pu2clr/auto_bpf_arduino/extras/auto_band_pass_filter.sch

## EAGLE design extras/auto_band_pass_filter.sch (2020-11-26)

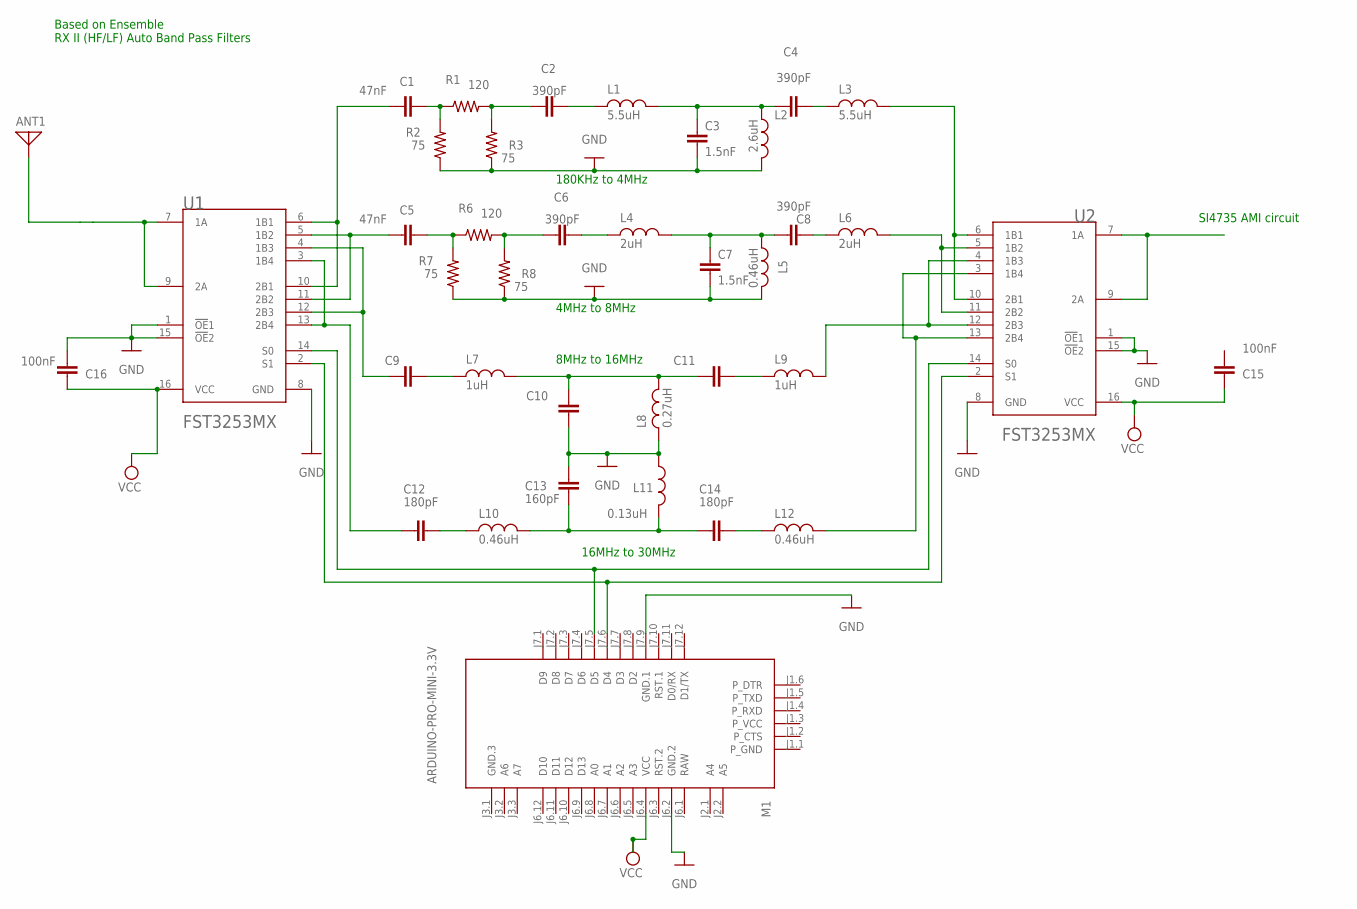
[picture p11: schematic auto_band_pass_filter.sch]

Parts:
ANT1: ANTENNA; PAD-01
C1, C5: 47nF; C2.5-3
C2, C4, C6, C8: 390pF; C2.5-3
C3, C7: 1.5nF; C2.5-3
C9, C10, C11: C2,5-3; C2.5-3
C12, C14: 180pF; C2.5-3
C13: 160pF; C2.5-3
C15, C16: 100nF; C2.5-3
M1: ARDUINO-PRO-MINI-3.3V; ARDUINO-PRO-MINI
R1, R6: 120; RESAD724W46L381D178B
R2, R3, R7, R8: 75; RESAD724W46L381D178B
U1, U2: FAIRCHILD_FST3253MXFAIRCHILD_FST3253MX_0_0; FAIRCHILD_FST3253MX_0

Connections:
GND: C3.2, C7.2, C10.1, C13.1, C16.2, M1.J6.2 (GND.2), M1.J7.9 (GND.1), R2.1, R3.1, R7.1, R8.1, U1.1 (!OE!1), U1.8 (GND), U1.15 (!OE!2), U2.1 (!OE!1), U2.8 (GND), U2.15 (!OE!2)
unnamed: C1.1, U1.6 (1B1), U1.10 (2B1)
unnamed: C3.1, C4.1
unnamed: C10.2, C11.1
unnamed: C13.2, C14.1
unnamed: C5.1, U1.5 (1B2), U1.11 (2B2)
unnamed: C1.2, R1.1, R2.2
unnamed: C2.1, R1.2, R3.2
unnamed: C7.1, C8.1
unnamed: C9.1, U1.4 (1B3), U1.12 (2B3)
unnamed: M1.J7.5 (D5), U1.14 (S0), U2.14 (S0)
unnamed: C5.2, R6.1, R7.2
unnamed: C6.1, R6.2, R8.2
unnamed: M1.J7.6 (D4), U1.2 (S1), U2.2 (S1)
unnamed: ANT1.1, U1.7 (1A), U1.9 (2A)
unnamed: U2.5 (1B2), U2.11 (2B2)
unnamed: C12.1, U1.3 (1B4), U1.13 (2B4)
unnamed: U2.6 (1B1), U2.10 (2B1)
unnamed: U2.7 (1A), U2.9 (2A)
unnamed: U2.4 (1B3), U2.12 (2B3)
unnamed: U2.3 (1B4), U2.13 (2B4)
VCC: C15.1, C16.1, M1.J6.4 (VCC), U1.16 (VCC), U2.16 (VCC)

Notes on the sheet:
180KHz to 4MHz
8MHz to 16MHz
16MHz to 30MHz
SI4735 AMI circuit
4MHz to 8MHz
Based on Ensemble RX II (HF/LF) Auto Band Pass Filters
