pu2clr/auto_bpf_arduino/extras/custom_band_pass_filter_calc.sch

## EAGLE design extras/custom_band_pass_filter_calc.sch (2020-11-27)

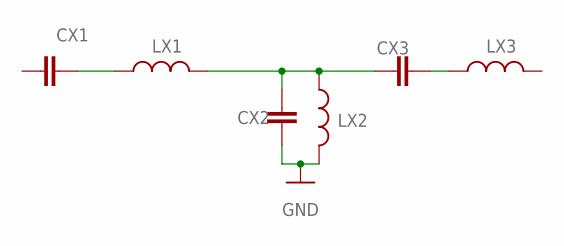
[picture p12: schematic custom_band_pass_filter_calc.sch]

Parts:
CX1, CX2, CX3: C2,5-3; C2.5-3

Connections:
GND: CX2.2
unnamed: CX2.1, CX3.1
