pu2clr/auto_bpf_arduino/(threads)

Thread 1 (2021-02-03):

Schematic issue

mrgadotti, 2021-02-03:
The values from C9, C10, C11 aren't present on the schematic.
