pu2clr/auto_bpf_arduino/Arduino/mcp23008/mcp23008.cpp

#include "mcp23008.h"

#include <Wire.h>

/**
 * @brief Starts the MCP23008 
 * 
 * @param i2c I2C address (0x20 ~ 0x27) - default 0x20
 * @param io  If GPIO_OUTPUT (0), all  GPIO PINS will configured to output
 *            If GPIO_INPUT  (255), all GPIO PINS will configured to input  
 *            You also can use a bitmask to configure some pins for input and other pins for output. 
 */
void MCP::setup(uint8_t i2c, uint8_t io) {
  
    Wire.begin(); //creates a Wire object
  
    this->i2cAddress = i2c;
    this->setRegister(REG_IODIR, io);    // All GPIO pins are configured to input (1)  or output (0)
    this->setGPIOS(0);                   // // Sets all port to 0
}  

/**
 * @brief Gets the corrent register information. 
 * 
 * @param reg  (0x00 ~ 0xA) see MCP23008 registers documentation 
 * @return uint8_t current register value
 */
uint8_t MCP::getRegister(uint8_t reg) {
    Wire.beginTransmission(this->i2cAddress);
    Wire.write(reg);
    Wire.endTransmission();
    Wire.requestFrom(this->i2cAddress, 1); // reading 0x0A register
    return Wire.read();
}

/**
 * @brief Sets a value to a given register
 * 
 * @param reg   (0x00 ~ 0xA) see MCP23008 registers documentation 
 * @param value value (8 bits)
 */
void MCP::setRegister(uint8_t reg, uint8_t value) {
    Wire.beginTransmission(this->i2cAddress);
    Wire.write(reg);
    Wire.write(value);
    Wire.endTransmission(); //ends communication with the device
}

/**
 * @brief Sets a value to the GPIO Register
 * 
 * @param value (8 bits)
 */
void MCP::setGPIOS(uint8_t value) {
    this->gpios = value;
    setRegister(REG_GPIO, value);
    Wire.beginTransmission(i2cAddress);
}


/**
 * @brief Turns a given GPIO port on (high level)
 * 
 * @param gpio the GPIO/PIN number (0-7)
 */
void MCP::turnGpioOn(uint8_t gpio)
{
    uint8_t b = (1 << gpio);
    // Checks if it is already ON (avoid trafic on I2C)
    if ( (bool)(gpios & b) || gpio > 7 )
        return;
    gpios = gpios | b;
    setGPIOS(gpios);
}

/**
 * @brief Turns a given GPIO port off (low level)
 * 
 * @param gpio the GPIO/PIN number (0-7)
 */
void MCP::turnGpioOff(uint8_t gpio)
{
    uint8_t b = (1 << gpio);
    // Checks if it is already OFF
    if ((gpios & b) == 0 || gpio > 7)
        return;
    gpios = gpios ^ b;
    setGPIOS(gpios);
}

/**
 * @brief Turns intenal pull up resistor ON  to  a given GPIO PIN (high level)
 * 
 * @param gpio the GPIO/PIN number (0-7)
 */
void MCP::pullUpGpioOn(uint8_t gpio)
{
    // TODO
    uint8_t b = (1 << gpio);
    uint8_t gppu; 

    if (gpio > 7) 
        return;
        
    gppu |= 1 << gpio;

    setRegister(REG_GPPU, gppu);
}

/**
 * @brief Turns intenal pull up resistor OFF  to a given GPIO PIN (low level)
 * 
 * @param gpio the GPIO/PIN number (0-7)
 */
void MCP::pullUpGpioOff(uint8_t gpio)
{
    // TODO
    uint8_t b = (1 << gpio);
    uint8_t gppu;

    if (gpio > 7)
        return;

    gppu &= ~(1 << gpio);

    setRegister(REG_GPPU, gppu);
}
