pu2clr/auto_bpf_arduino/(commit log)

2020-07-29 HF BPF Controlled by Arduino
    [auto_band_pass_filter.sch]
2020-07-29 HF PBF Controlled by Arduino
2020-07-29 HF Bandpass filter controlled by Arduino
2020-07-30 Band Pass Filter controlled by Arduino
2020-08-07 Auto bandpass filter
    [auto_band_pass_filter.sch]
2020-08-07 Auto Bandpass Filter controlled by Arduino
2020-08-07 Bandpass filter controlled by Arduino
2020-08-07 BPF Arduino sources
2020-08-07 BPF controlled by Arduino
2020-08-07 PBF controlled by Arduino
2020-12-09 BPF Arduino
2021-02-05 Si47XX Arduino Library
2022-04-25 BPF controled by Arduino
